detectoresymicroelectronica/proyecto-integrador-gamma-tracker/hardware/EVB-TIA-v0/fab/EVB-TIA-v0_BOM.csv

Designator | Comment | Footprint | LCSC Part #
C1,C3 | 10n | Capacitor_SMD:C_0805_2012Metric
C2,C6,C10 | 100n | Capacitor_SMD:C_0805_2012Metric
C4 | 1u | Capacitor_SMD:C_1206_3216Metric
C5,C9 | 10u | Capacitor_SMD:C_0805_2012Metric
C11 | 1u | Capacitor_SMD:C_0805_2012Metric
D1 | BAT54S | Package_TO_SOT_SMD:SOT-23
R1,R2,R10 | 50 | Resistor_SMD:R_0603_1608Metric
R3 | 10 | Resistor_SMD:R_0603_1608Metric
R4,R5 | 1k | Resistor_SMD:R_0603_1608Metric
R6 | 2.2k | Resistor_SMD:R_0603_1608Metric
R7 | 3k | Resistor_SMD:R_0603_1608Metric
R8 | 750 | Resistor_SMD:R_0603_1608Metric
R9 | 240 | Resistor_SMD:R_0603_1608Metric
R11 | 10k | Resistor_SMD:R_0603_1608Metric
U1 | MICROFC-60035-SMT-TR1 | EVB-TIA:XDCR_MICROFC-60035-SMT-TR1 | C905854
U2 | ADA4895-1ARJZ-R2 | Package_TO_SOT_SMD:SOT-23-6 | C654293
