detectoresymicroelectronica/proyecto-integrador-gamma-tracker/hardware/EVB-TIA-v0/EVB-TIA-v0.pdf

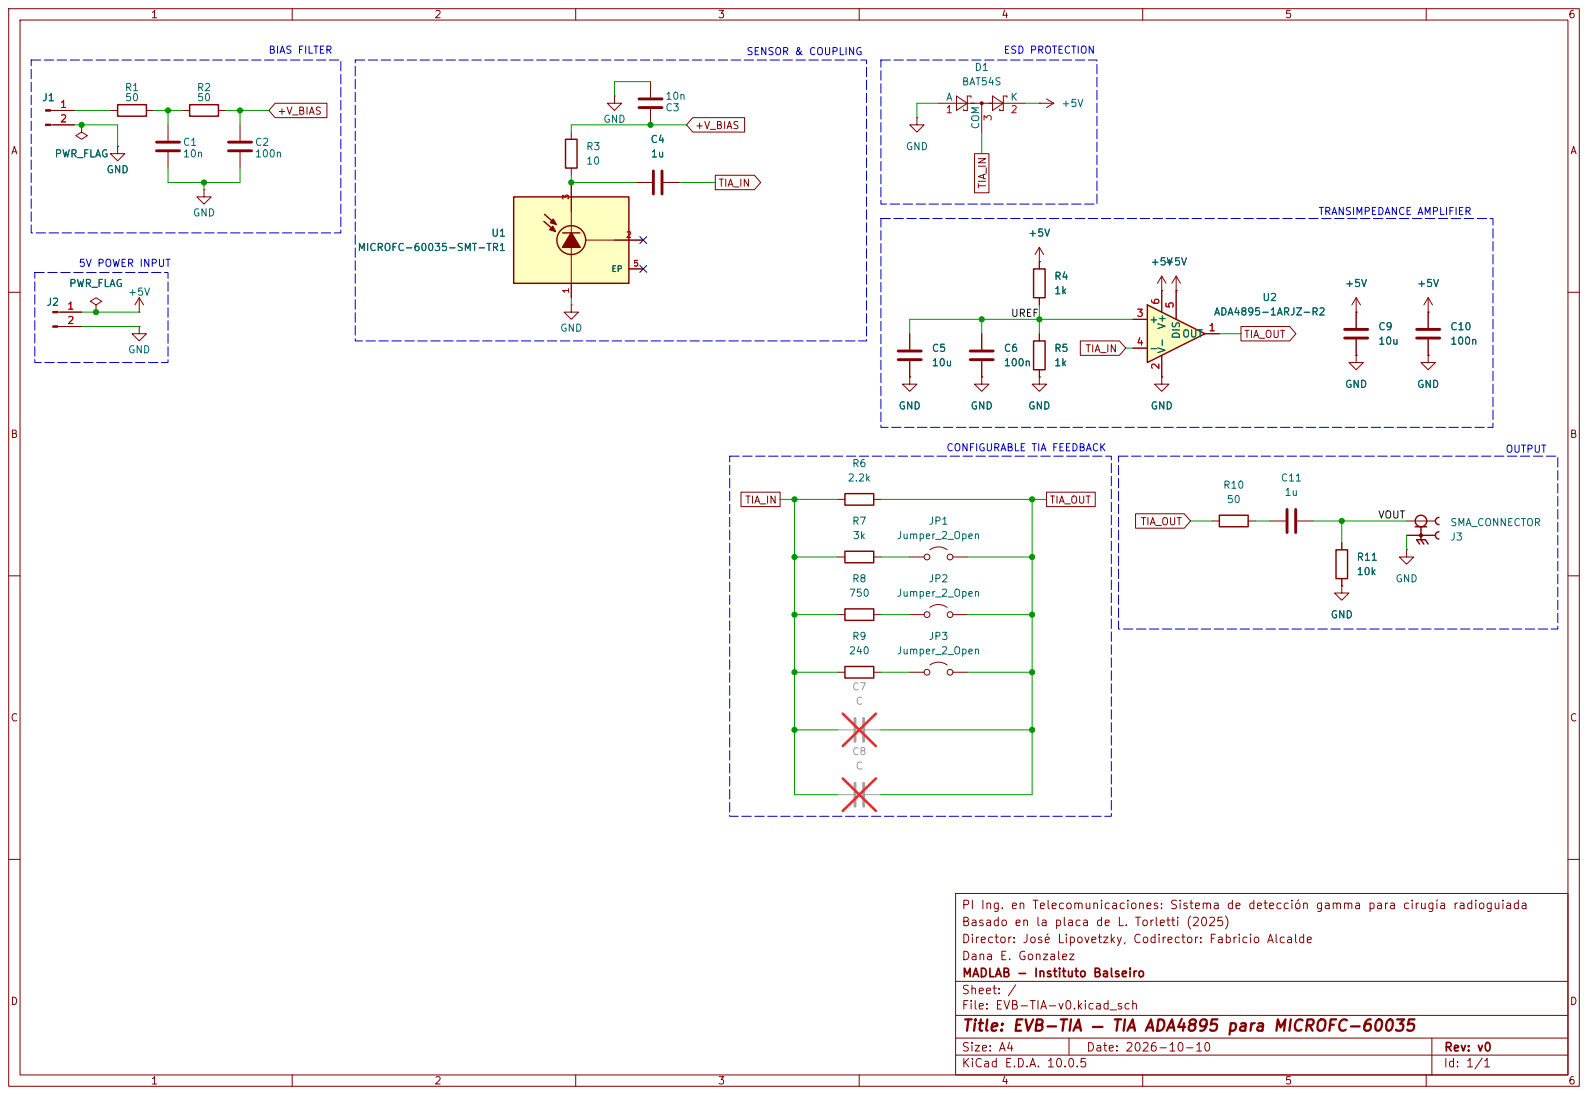
[picture p51: page 1]

PI Ing. en Telecomunicaciones: Sistema de detección gamma para cirugía radioguiada
Basado en la placa de L. Torletti (2025)
Director: José Lipovetzky, Codirector: Fabricio Alcalde
Dana E. Gonzalez
MADLAB - Instituto Balseiro
Sheet: /
File: EVB-TIA-v0.kicad_sch
Title: EVB-TIA — TIA ADA4895 para MICROFC-60035

Size: A4 | Rev: v0
KiCad E.D.A. 10.0.5 | Id: 1/1
