detectoresymicroelectronica/proyecto-integrador-gamma-tracker/hardware/EVB-TIA-v0/EVB-TIA-v0.kicad_pcb

## KiCad design hardware/EVB-TIA-v0/EVB-TIA-v0.kicad_pcb (2026-10-20)

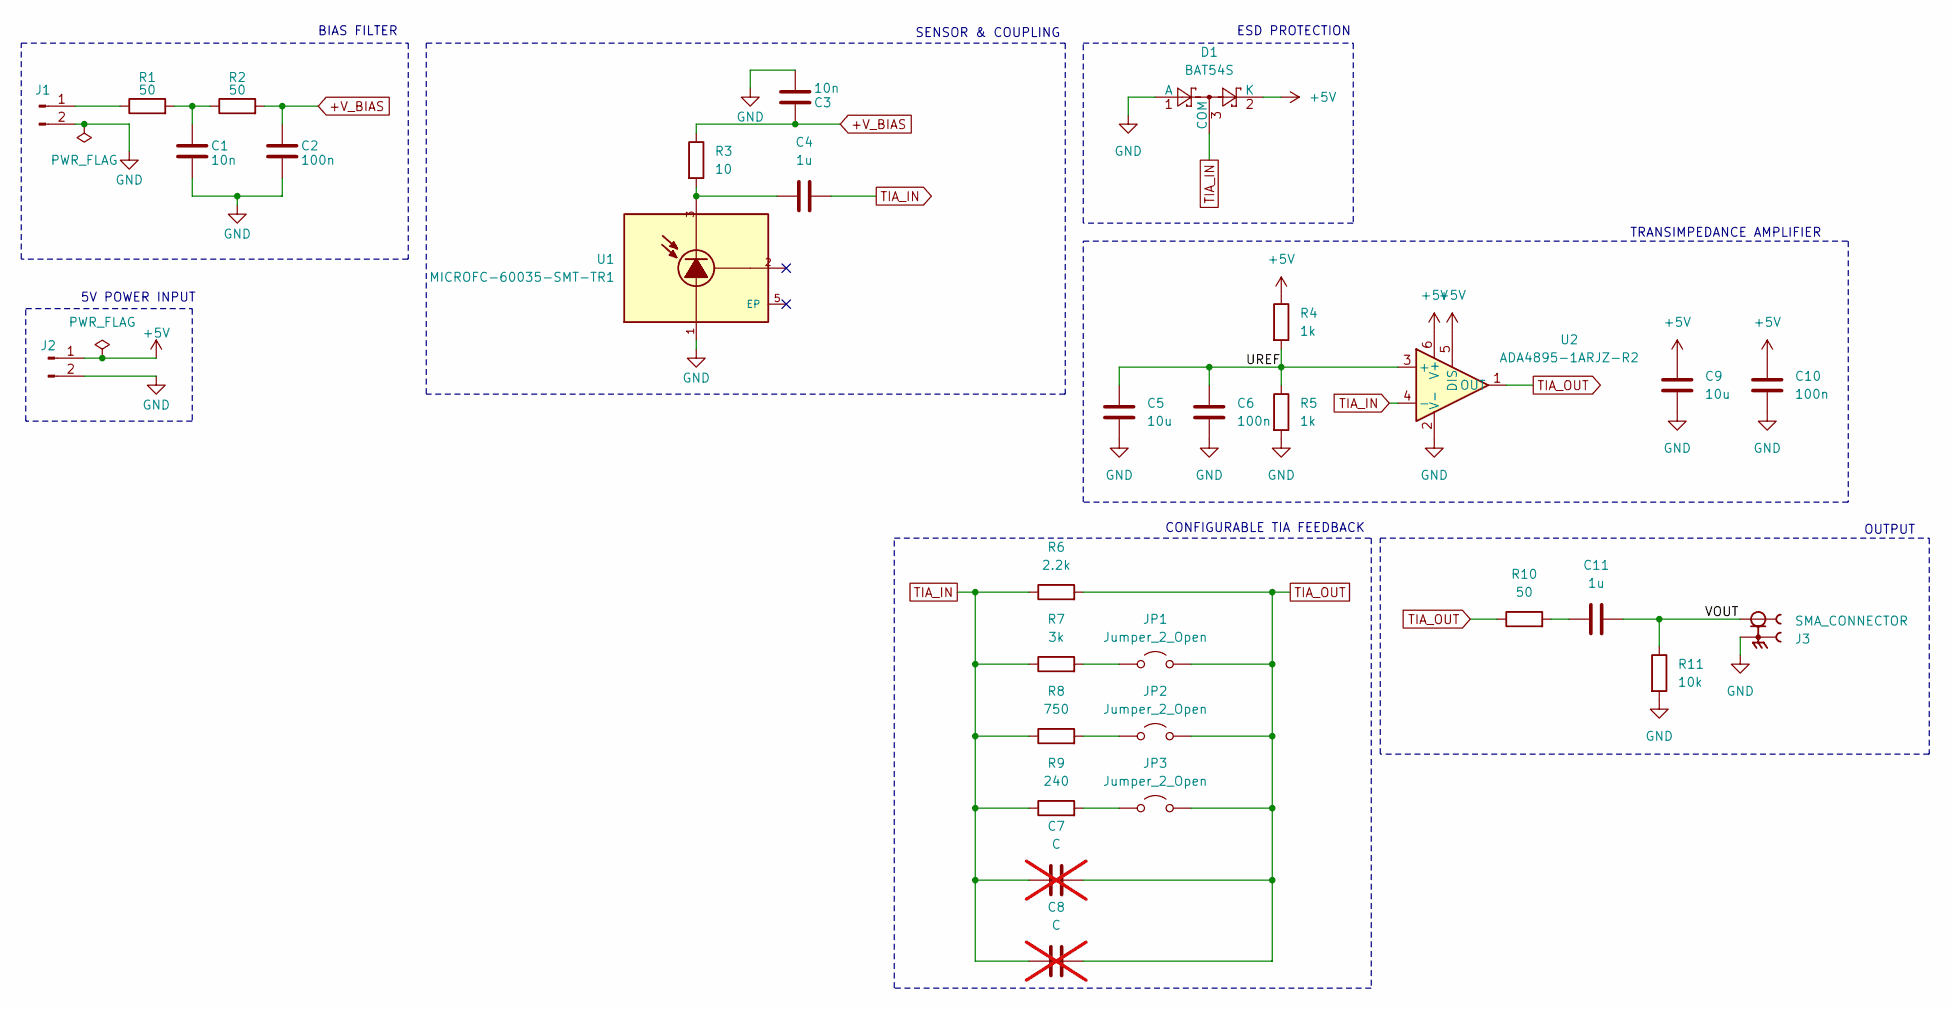
[picture p52: schematic EVB-TIA-v0.kicad_sch, EVB-TIA — TIA ADA4895 para MICROFC-60035]

Parts:
C1, C3: 10n; C_0805_2012Metric
C2, C6, C10: 100n; C_0805_2012Metric
C4: 1u; C_1206_3216Metric
C5, C9: 10u; C_0805_2012Metric
C7, C8: C; C_0603_1608Metric_Pad1.08x0.95mm_HandSolder; not fitted
C11: 1u; C_0805_2012Metric
D1: BAT54S; SOT-23
J1, J2: Conn_01x02_Pin; PinHeader_1x02_P2.54mm_Vertical
J3: SMA_CONNECTOR; LPRS_SMA_CONNECTOR_ANCHITO; PARTREV 1.3
JP1, JP2, JP3: Jumper_2_Open; PinHeader_1x02_P2.54mm_Vertical
R1, R2, R10: 50; R_0603_1608Metric
R3: 10; R_0603_1608Metric
R4, R5: 1k; R_0603_1608Metric
R6: 2.2k; R_0603_1608Metric
R7: 3k; R_0603_1608Metric
R8: 750; R_0603_1608Metric
R9: 240; R_0603_1608Metric
R11: 10k; R_0603_1608Metric
U1: MICROFC-60035-SMT-TR1; XDCR_MICROFC-60035-SMT-TR1; PARTREV 31 JUL 2018; LCSC C905854
U2: ADA4895-1ARJZ-R2; SOT-23-6; LCSC C654293

Connections:
+5V: C9.1, C10.1, D1.2 (K), J2.1, R4.1, U2.5 (DIS), U2.6 (V+)
+V_BIAS: C2.1, C3.1, R2.2, R3.1
/UREF: C5.1, C6.1, R4.2, R5.1, U2.3 (+)
/VOUT: C11.2, J3.1, R11.1
GND: C1.2, C2.2, C3.2, C5.2, C6.2, C9.2, C10.2, D1.1 (A), J1.2, J2.2, J3.G1, J3.G2, J3.G3, J3.G4, R5.2, R11.2, U1.1, U2.2 (V-)
unnamed: C1.1, R1.2, R2.1
unnamed: C4.1, R3.2, U1.3
unnamed: C11.1, R10.2
unnamed: J1.1, R1.1
unnamed: JP1.1 (A), R7.2
unnamed: JP2.1 (A), R8.2
unnamed: JP3.1 (A), R9.2
TIA_IN: C4.2, C7.1, C8.1, D1.3 (COM), R6.1, R7.1, R8.1, R9.1, U2.4 (-)
TIA_OUT: C7.2, C8.2, JP1.2 (B), JP2.2 (B), JP3.2 (B), R6.2, R10.1, U2.1 (OUT)

Notes on the sheet:
ESD PROTECTION
OUTPUT
CONFIGURABLE TIA FEEDBACK
BIAS FILTER
5V POWER INPUT
TRANSIMPEDANCE AMPLIFIER
SENSOR & COUPLING

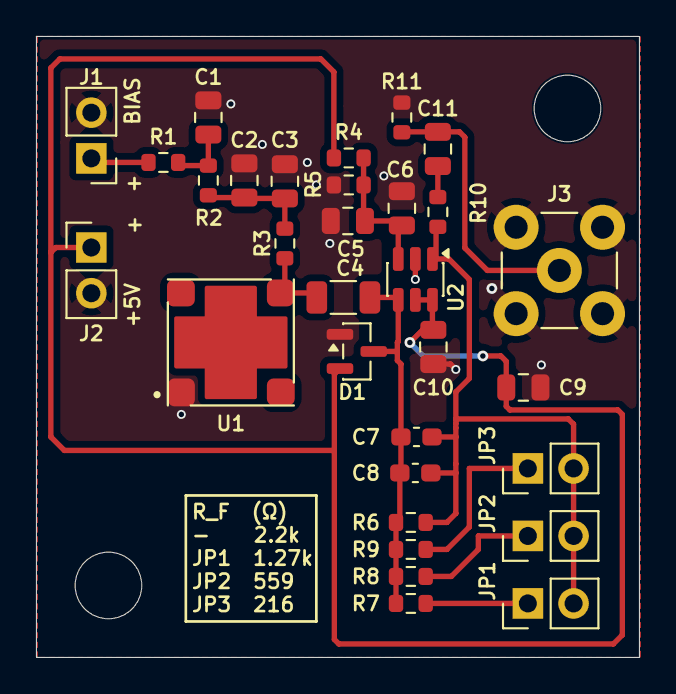
[picture p53: board EVB-TIA-v0.kicad_pcb from above]

Board: 2 copper layers, 33.5 x 34.5 mm, 33 parts (0 on the bottom side), 14 nets.

Other parts of the board:
H1, H2: MountingHole_3.7mm
