detectoresymicroelectronica/proyecto-integrador-gamma-tracker/(commit log)

2026-08-11 Create .gitkeep
    Genero la carpeta de logs
2026-08-11 Create .gitkeep
    Creo la carpeta de scripts/read
2026-08-11 Create .gitkeep
    Creo la carpeta scripts/analysis
2026-08-11 Create .gitkeep
    Creo la carpeta data/SiPM/raw
2026-08-11 Subo script principal de medicion (Keithley2450)
2026-08-11 Add script de barrido NPLC
2026-08-11 Add script graficador/comparador de csv
2026-08-11 Create .gitkeep
    Creo la carpeta MFC60035
2026-08-11 Add mediciones de los 10 SiPM
    Estas son las hechas el mismo dia (11.08)
    [MFC60035_01.csv, MFC60035_02.csv, MFC60035_03.csv, MFC60035_04.csv, MFC60035_05.csv, MFC60035_06.csv, MFC60035_07.csv, MFC60035_08.csv]
2026-08-11 Add mediciones del 10-08-26
    [MFC60035_01_10-08.csv, MFC60035_02_10-08.csv, MFC60035_03_10-08.csv, MFC60035_04_10-08.csv, MFC60035_05_10-08.csv]
2026-08-11 Subo las mediciones del 11-08-2026
    [MFC60035_01.csv, MFC60035_02.csv, MFC60035_03.csv, MFC60035_04.csv, MFC60035_05.csv, MFC60035_06.csv, MFC60035_07.csv, MFC60035_08.csv]
2026-08-11 Subo las updates del cuaderno de laboratorio
2026-08-12 Imagenes para completar los logs
2026-08-12 Update 2 LOG — Lunes 10 de agosto de 2026.md
2026-08-12 Update 3 LOG — Martes 11 de agosto de 2026.md
2026-08-12 Update 1 LOG — Lunes 3 de agosto de 2026.md
2026-08-18 Subo imagenes del diseno de la placav1
2026-08-18 Subo el log del dia
2026-08-18 Update 4 LOG — Martes 18 de agosto de 2026.md
2026-08-24 Subo el log del dia de hoy
2026-08-24 Subo los scripts del dia de hoy
2026-08-25 Create .gitkeep para crear la carpeta de data
2026-08-25 Subo los csv de las mediciones DCR
    [DCR_MFC60035_01.csv, DCR_MFC60035_02.csv, DCR_MFC60035_03.csv, DCR_MFC60035_04.csv, DCR_MFC60035_05.csv, DCR_MFC60035_06.csv, DCR_MFC60035_07.csv, DCR_MFC60035_08.csv]
2026-08-25 Subo datos de la medicion del drift
    [DRIFT_MFC60035_01_20260824_135646.csv]
2026-08-26 Script para medir dark counts
2026-08-26 Imagenes para el log 6
2026-08-26 Log de ayer
2026-08-26 Update 6 LOG — Martes 25 de agosto de 2026.md
2026-09-15 Update 7 LOG — Miercoles 9 de septiembre de 2026.md
2026-09-23 Subo el log9
2026-09-24 Update 9 LOG — Miércoles 23 de septiembre de 2026.md
2026-09-24 subo memorias de calculo
2026-10-20 subo las imagenes de los logs
2026-10-20 Update 10 LOG — Sábado 10 de octubre de 2026.md
2026-10-20 Update 11 LOG — Martes 13 de octubre de 2026.md
2026-10-20 Update 12 LOG — Martes 20 de octubre de 2026.md
2026-10-20 Subo parte de los archivos kicad
2026-10-20 subo los archivos de fabricacion de la placa
2026-10-20 subo el esquematico de la placa
2026-10-21 subo el diagrama de flujo del TIA
2026-10-21 subo la trazabilidad de la EVB
